Cogman-1/Macropad_V1_PCB/Macropad_V1.kicad_pcb

## KiCad design Macropad_V1.kicad_pcb (2026-10-30)

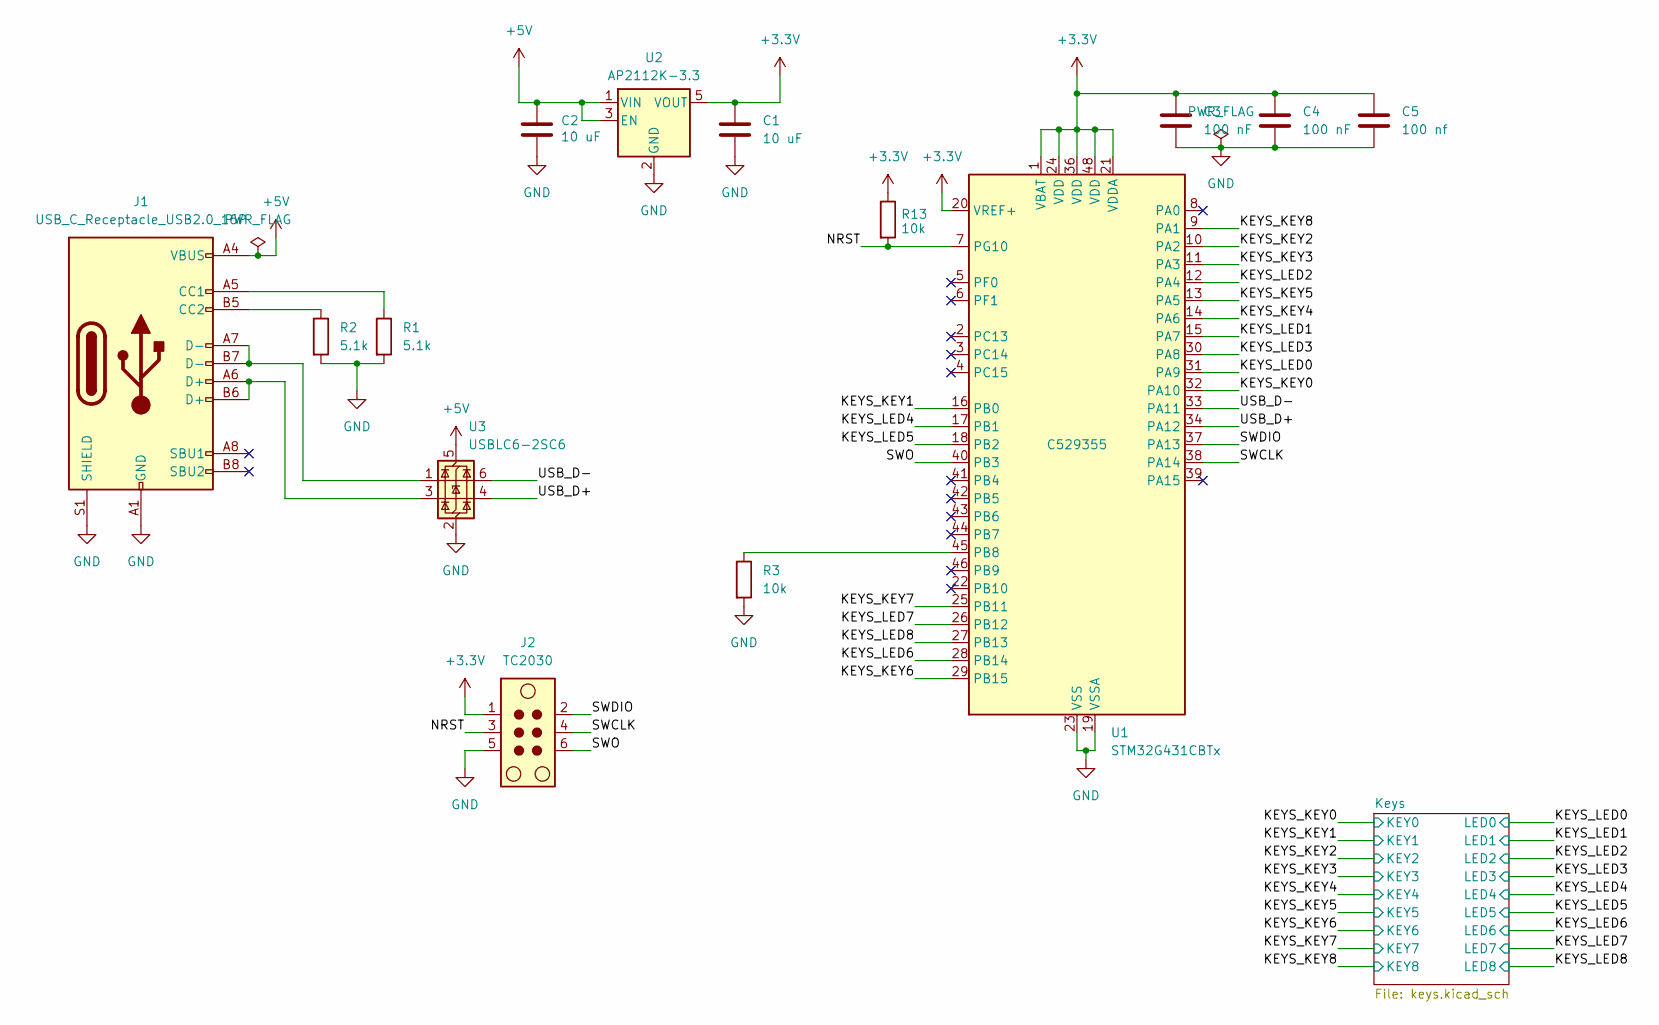
[picture p1: schematic Macropad_V1.kicad_sch, Macropad v1]

Parts:
C1, C2: 10 uF; C_0805_2012Metric; LCSC C15850
C3, C4: 100 nF; C_0805_2012Metric; LCSC C28233
C5: 100 nf; C_0805_2012Metric; LCSC C28233
J1: USB_C_Receptacle_USB2.0_16P; USB_C_Receptacle_XKB_U262-16XN-4BVC11; LCSC C319148
J2: TC2030; Tag-Connect_TC2030-IDC-NL_2x03_P1.27mm_Vertical
R1, R2: 5.1k; R_0805_2012Metric; LCSC C27834
R3, R13: 10k; R_0805_2012Metric; LCSC C17414
U1: STM32G431CBTx; LQFP-48_7x7mm_P0.5mm; LCSC C529355
U2: AP2112K-3.3; SOT-23-5; LCSC C51118
U3: USBLC6-2SC6; SOT-23-6; LCSC C7519

Connections:
+3.3V: C1.1, C3.1, C4.1, C5.1, J2.1, R13.1, U1.1 (VBAT), U1.20 (VREF+), U1.21 (VDDA), U1.24 (VDD), U1.36 (VDD), U1.48 (VDD), U2.5 (VOUT)
+5V: C2.1, J1.A4 (VBUS), J1.A9 (VBUS), J1.B4 (VBUS), J1.B9 (VBUS), U2.1 (VIN), U2.3 (EN), U3.5 (VBUS)
/KEYS_KEY0: U1.32 (PA10); also elsewhere on the board
/KEYS_KEY1: U1.16 (PB0); also elsewhere on the board
/KEYS_KEY2: U1.10 (PA2); also elsewhere on the board
/KEYS_KEY3: U1.11 (PA3); also elsewhere on the board
/KEYS_KEY4: U1.14 (PA6); also elsewhere on the board
/KEYS_KEY5: U1.13 (PA5); also elsewhere on the board
/KEYS_KEY6: U1.29 (PB15); also elsewhere on the board
/KEYS_KEY7: U1.25 (PB11); also elsewhere on the board
/KEYS_KEY8: U1.9 (PA1); also elsewhere on the board
/KEYS_LED0: U1.31 (PA9); also elsewhere on the board
/KEYS_LED1: U1.15 (PA7); also elsewhere on the board
/KEYS_LED2: U1.12 (PA4); also elsewhere on the board
/KEYS_LED3: U1.30 (PA8); also elsewhere on the board
/KEYS_LED4: U1.17 (PB1); also elsewhere on the board
/KEYS_LED5: U1.18 (PB2); also elsewhere on the board
/KEYS_LED6: U1.28 (PB14); also elsewhere on the board
/KEYS_LED7: U1.26 (PB12); also elsewhere on the board
/KEYS_LED8: U1.27 (PB13); also elsewhere on the board
/NRST: J2.3, R13.2, U1.7 (PG10)
/SWCLK: J2.4, U1.38 (PA14)
/SWDIO: J2.2, U1.37 (PA13)
/SWO: J2.6, U1.40 (PB3)
/USB_D+: U1.34 (PA12), U3.4 (I/O2)
/USB_D-: U1.33 (PA11), U3.6 (I/O1)
GND: C1.2, C2.2, C3.2, C4.2, C5.2, J1.A1 (GND), J1.A12 (GND), J1.B1 (GND), J1.B12 (GND), J1.S1 (SHIELD), J2.5, R1.2, R2.2, R3.2, U1.19 (VSSA), U1.23 (VSS), U1.35 (VSS), U1.47 (VSS), U2.2 (GND), U3.2 (GND); also elsewhere on the board
unnamed: J1.A5 (CC1), R1.1
unnamed: J1.B5 (CC2), R2.1
unnamed: J1.A6 (D+), J1.B6 (D+), U3.3 (I/O2)
unnamed: J1.A7 (D-), J1.B7 (D-), U3.1 (I/O1)
unnamed: R3.1, U1.45 (PB8)

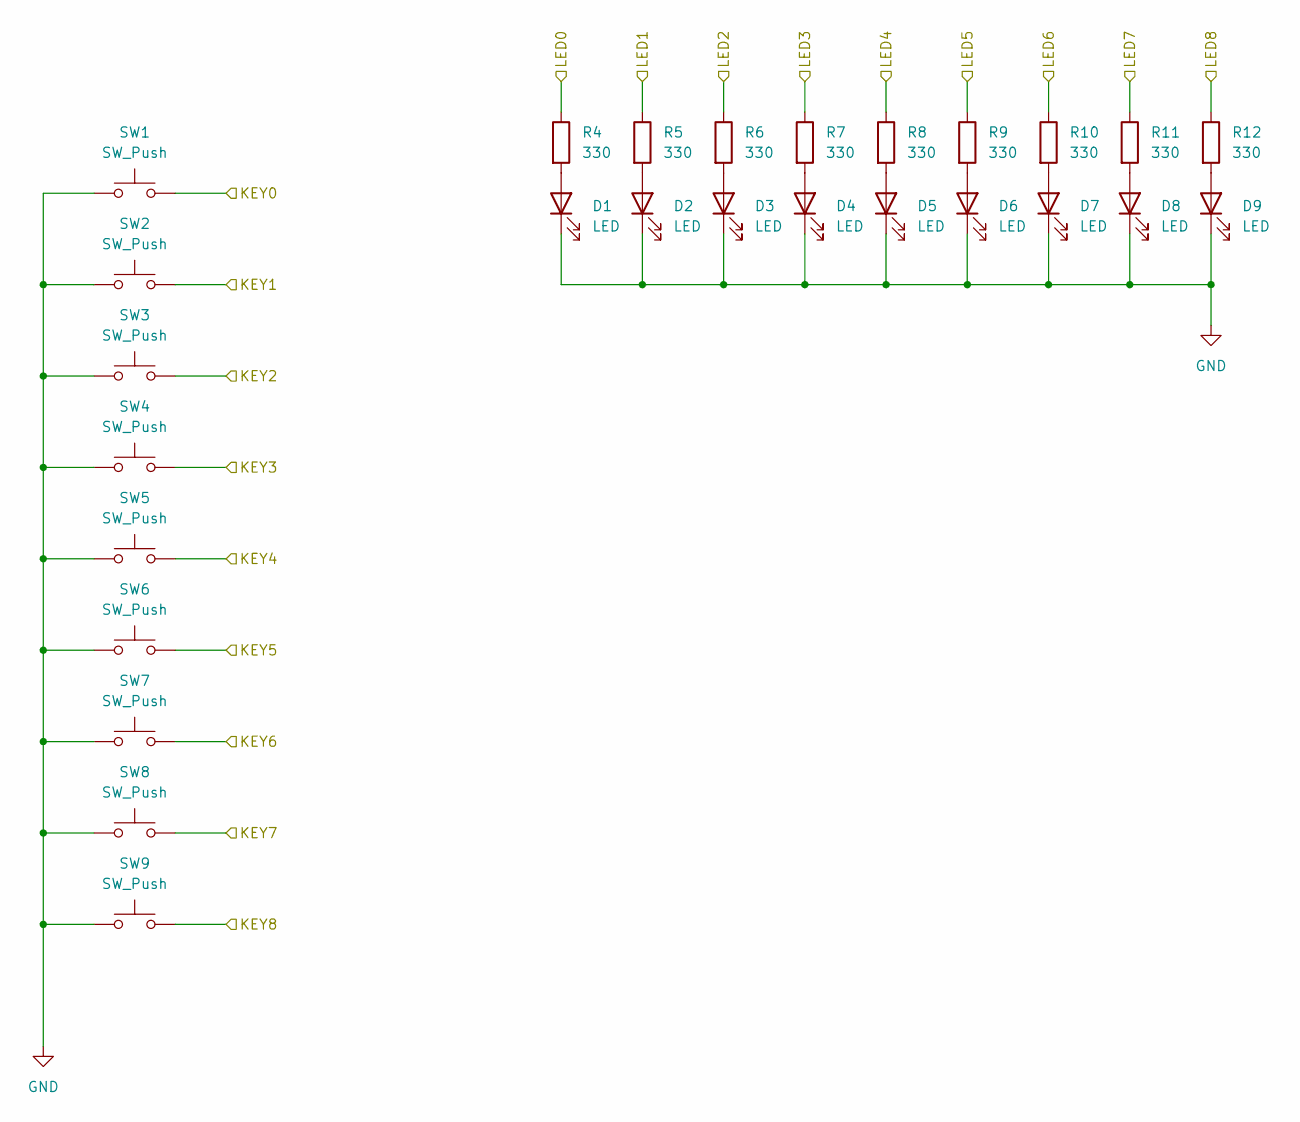
[picture p2: schematic keys.kicad_sch, Macropad v1 - Keys]

Parts:
D1, D2, D3, D4, D5, D6, D7, D8, D9: LED; LED_1206_3216Metric_ReverseMount_Hole1.8x2.4mm; LCSC C7496852
R4, R5, R6, R7, R8, R9, R10, R11, R12: 330; R_0805_2012Metric; LCSC C17630
SW1, SW2, SW3, SW4, SW5, SW6, SW7, SW8, SW9: SW_Push; SW_Cherry_MX_1.00u_PCB

Connections:
/KEYS_KEY0: SW1.2; also elsewhere on the board
/KEYS_KEY1: SW2.2; also elsewhere on the board
/KEYS_KEY2: SW3.2; also elsewhere on the board
/KEYS_KEY3: SW4.2; also elsewhere on the board
/KEYS_KEY4: SW5.2; also elsewhere on the board
/KEYS_KEY5: SW6.2; also elsewhere on the board
/KEYS_KEY6: SW7.2; also elsewhere on the board
/KEYS_KEY7: SW8.2; also elsewhere on the board
/KEYS_KEY8: SW9.2; also elsewhere on the board
/KEYS_LED0: R4.1; also elsewhere on the board
/KEYS_LED1: R5.1; also elsewhere on the board
/KEYS_LED2: R6.1; also elsewhere on the board
/KEYS_LED3: R7.1; also elsewhere on the board
/KEYS_LED4: R8.1; also elsewhere on the board
/KEYS_LED5: R9.1; also elsewhere on the board
/KEYS_LED6: R10.1; also elsewhere on the board
/KEYS_LED7: R11.1; also elsewhere on the board
/KEYS_LED8: R12.1; also elsewhere on the board
GND: D1.1 (K), D2.1 (K), D3.1 (K), D4.1 (K), D5.1 (K), D6.1 (K), D7.1 (K), D8.1 (K), D9.1 (K), SW1.1, SW2.1, SW3.1, SW4.1, SW5.1, SW6.1, SW7.1, SW8.1, SW9.1; also elsewhere on the board
unnamed: D1.2 (A), R4.2
unnamed: D2.2 (A), R5.2
unnamed: D3.2 (A), R6.2
unnamed: D4.2 (A), R7.2
unnamed: D5.2 (A), R8.2
unnamed: D6.2 (A), R9.2
unnamed: D7.2 (A), R10.2
unnamed: D8.2 (A), R11.2
unnamed: D9.2 (A), R12.2

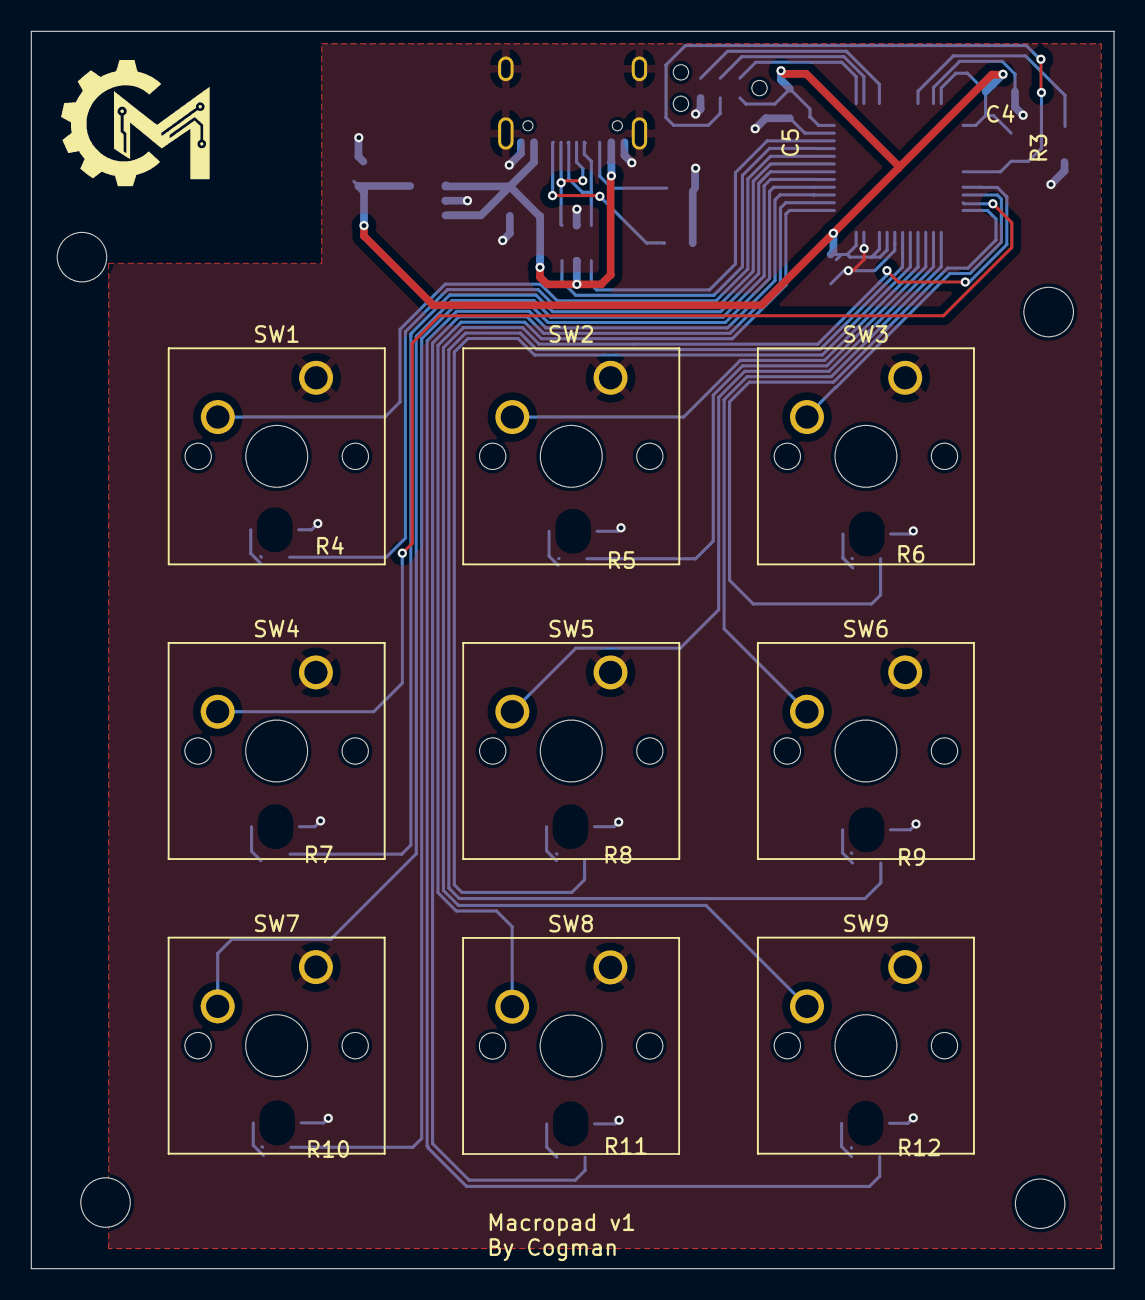
[picture p3: board Macropad_V1.kicad_pcb from above]

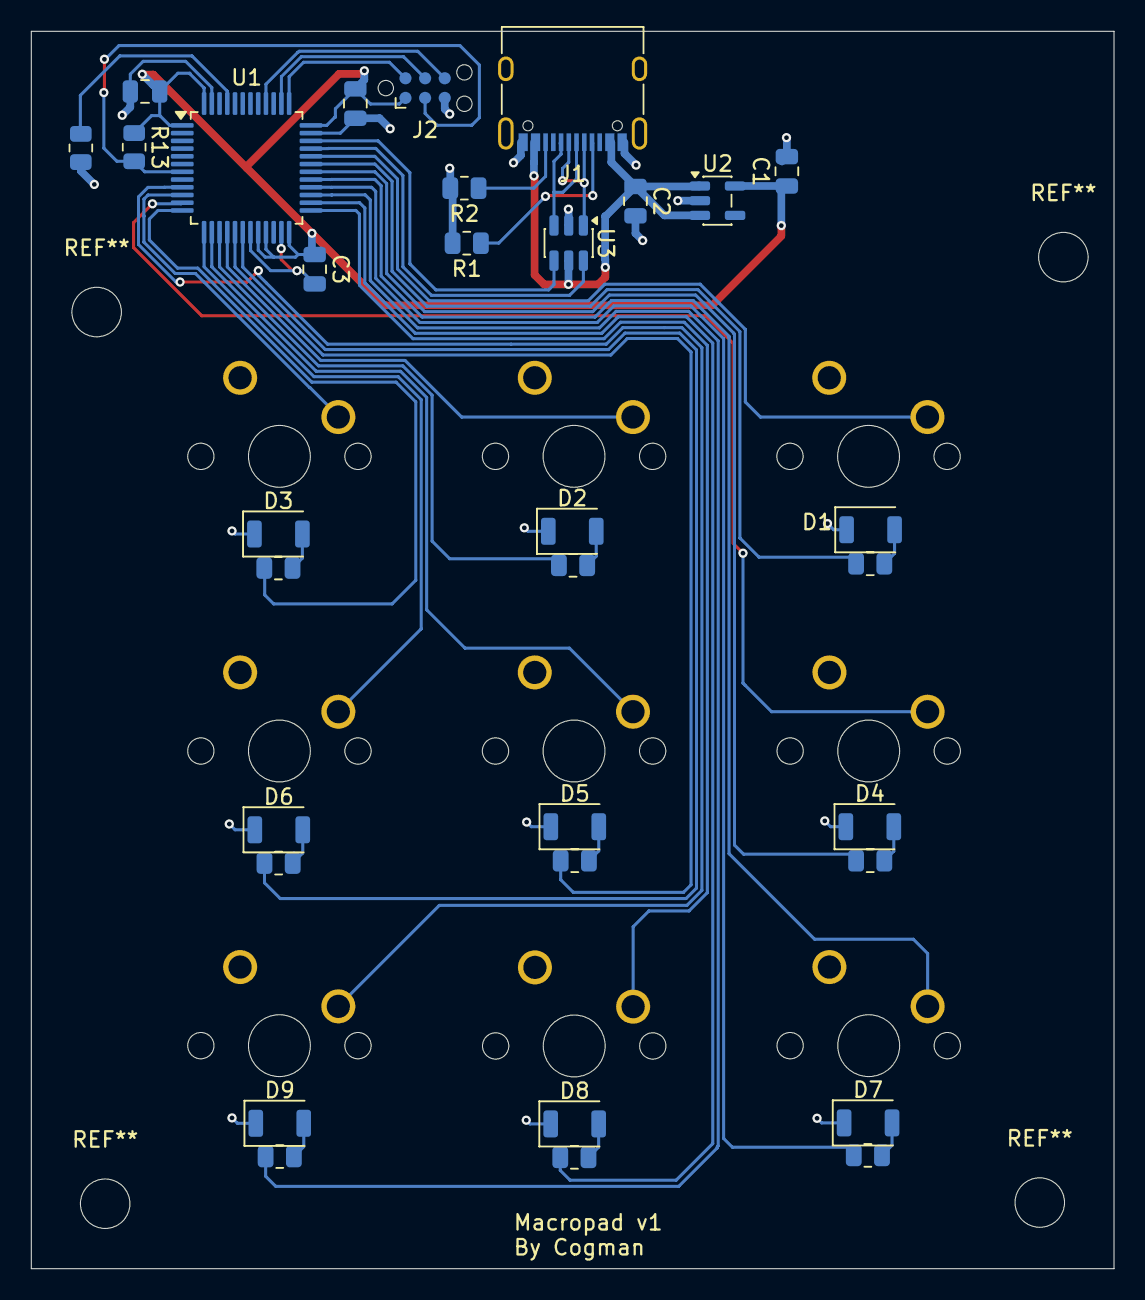
[picture p4: board Macropad_V1.kicad_pcb from below]

Board: 2 copper layers, 70.0 x 80.0 mm, 41 parts (32 on the bottom side), 41 nets.
