Cogman-1/Macropad_V1_PCB/(commit log)

2026-10-12 Initial Commit
    Add all files already developed
    [Macropad_V1.kicad_pcb, Macropad_V1.kicad_sch, keys.kicad_sch]
2026-10-30 Preparation for production and HW-Version - V0.1
    Current version of the PCB has been brought to production as the first version. The production uncovered wrong footprint assigned to the reverse mounted LEDs! Do not use for PCBA.
    [Macropad_V1.kicad_pcb, Macropad_V1.kicad_sch, keys.kicad_sch]
